basheeraltawil/parallel-manipulator-imu-control/docs/Presentation1.pptx

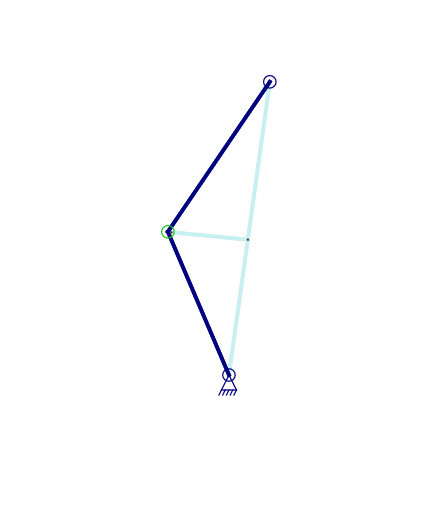
[picture p14: figure]

L2i

a

h

α

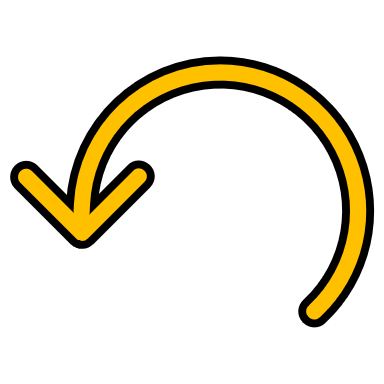
[picture p15: figure]
Line arrow Rotate left

L1i

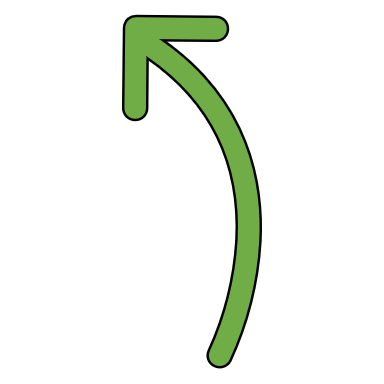
[picture p16: figure]
Line arrow Counter clockwise curve

a

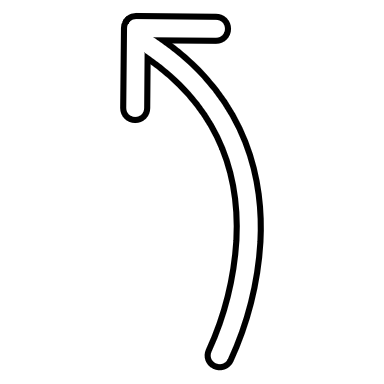
[picture p17: figure]
Line arrow Counter clockwise curve

θ

(β)

X

## Slide 2

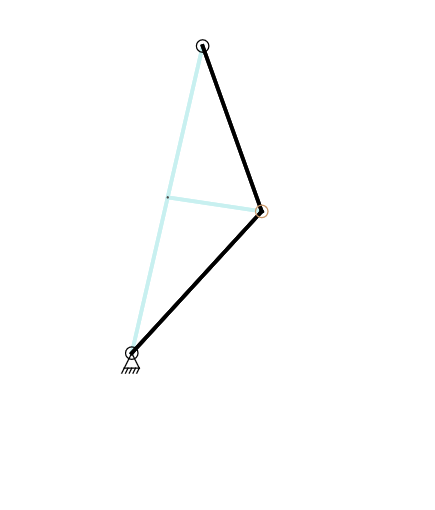
[picture p18: figure]

a

L2i

h

a

α

L1i

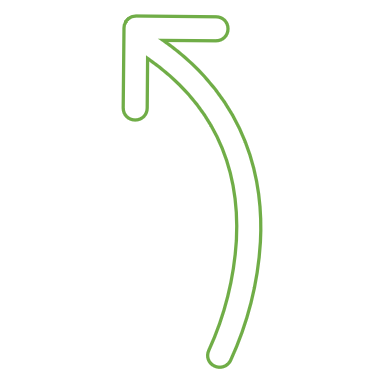
[picture p19: figure]
Line arrow Counter clockwise curve

(β)

θ

X
