basheeraltawil/parallel-manipulator-imu-control/docs/RO1.pptx

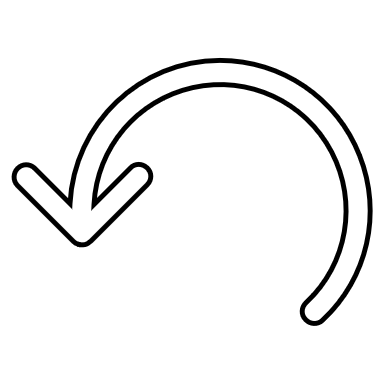
[picture p20: figure]
Line arrow Rotate left

θ 3

x_2

L13

y_0

L23

(P_(x3) ,P_(y3) )

Platform

(P_x ,P_y )

(P_(x2) ,P_(y2) )

L21

(P_(x1) ,P_(y1) )

L22

L11

Line arrow Counter clockwise curve

L12

θ 1

x_0

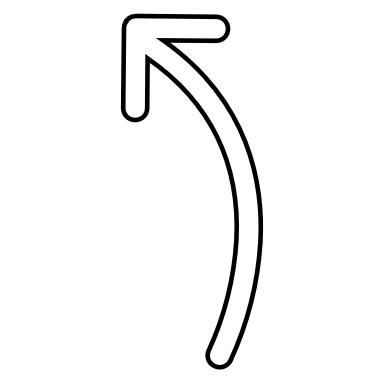
[picture p21: figure]
Line arrow Counter clockwise curve

θ 2

x_1

Page 1

## Slide 2
