basheeraltawil/parallel-manipulator-imu-control/docs/media/learning/fig09_dynamics.png

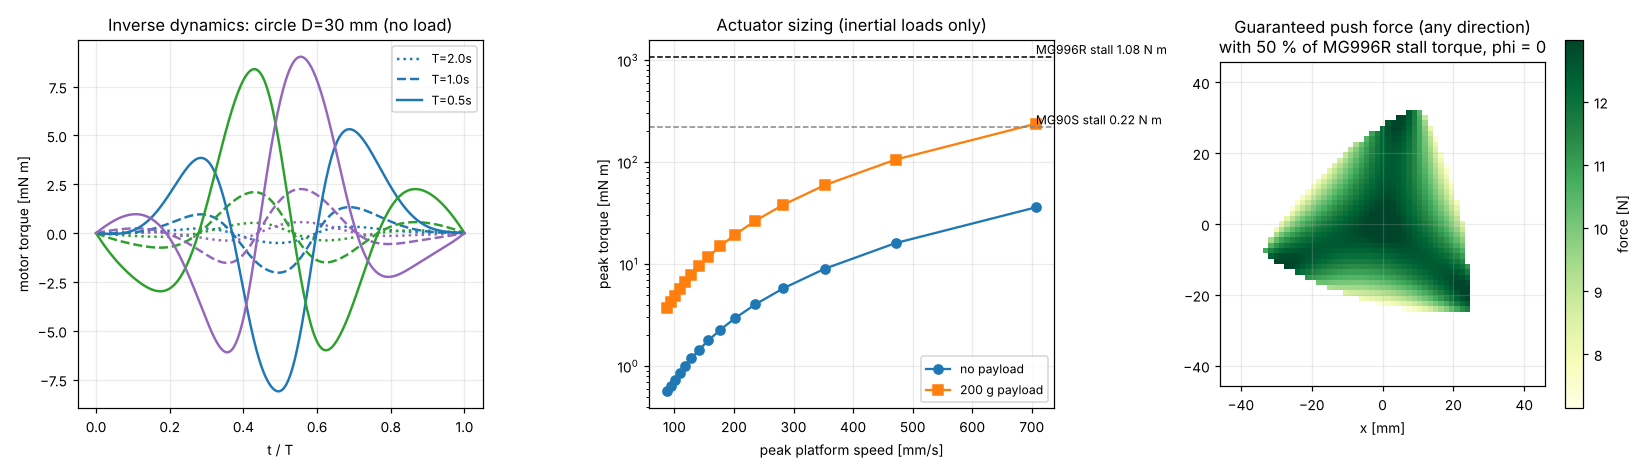
docs/media/learning/fig09_dynamics.png
