basheeraltawil/parallel-manipulator-imu-control/docs/media/learning/robot_render_top.png

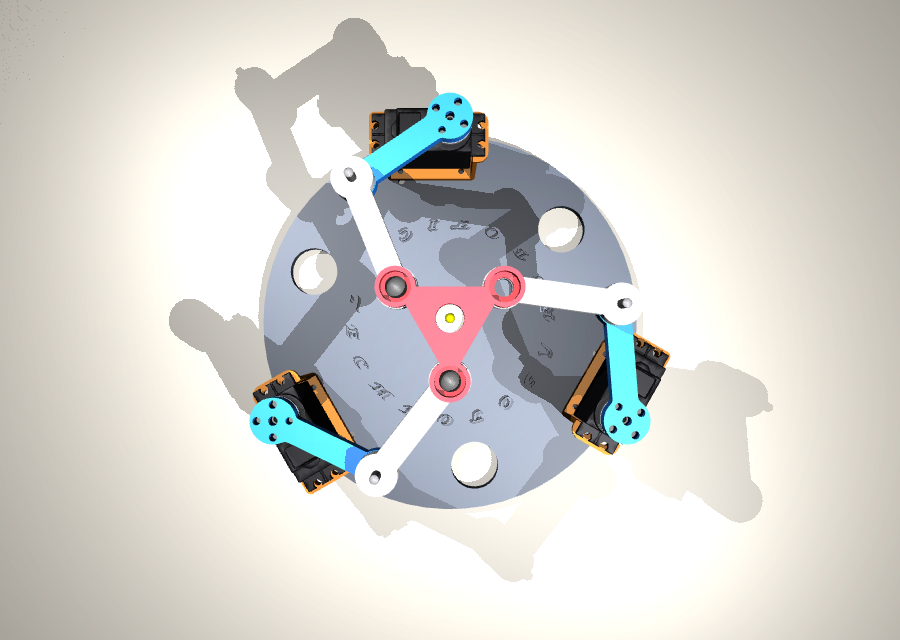
docs/media/learning/robot_render_top.png
