basheeraltawil/parallel-manipulator-imu-control/docs/media/overview.gif

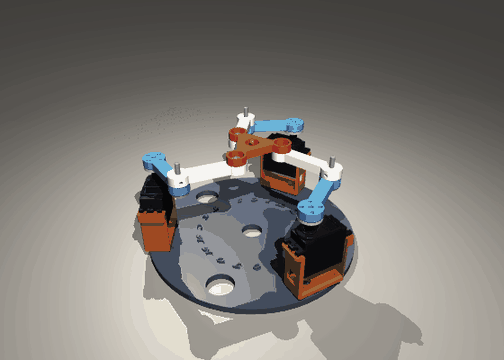
docs/media/overview.gif
