basheeraltawil/parallel-manipulator-imu-control/docs/media/scenarios/s1_imu_teleoperation.gif

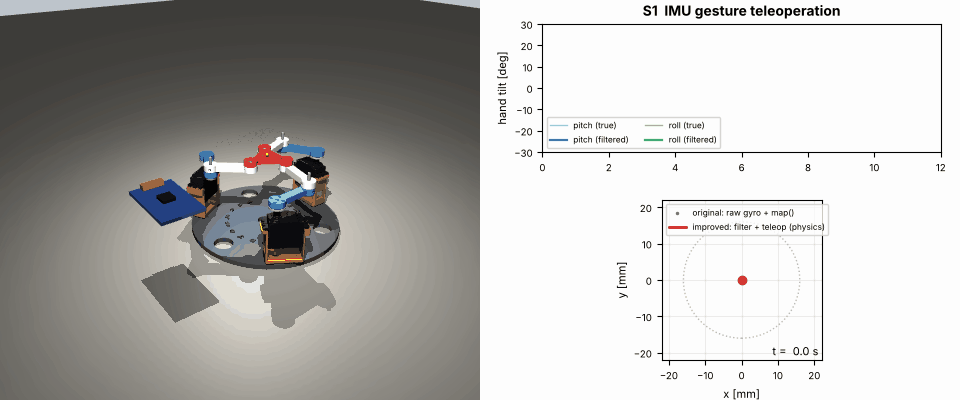
docs/media/scenarios/s1_imu_teleoperation.gif
