basheeraltawil/parallel-manipulator-imu-control/docs/media/scenarios/s2_precision_pick_place.gif

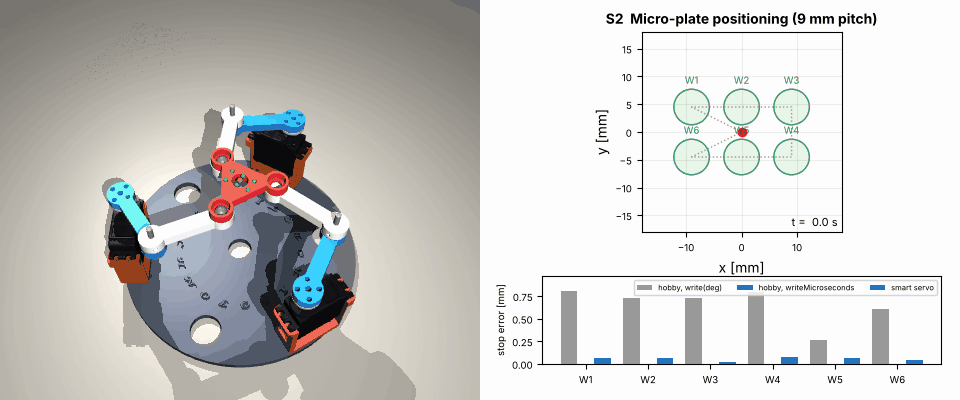
docs/media/scenarios/s2_precision_pick_place.gif
