basheeraltawil/parallel-manipulator-imu-control/hardware/vendor_models/mg90s/1.JPG

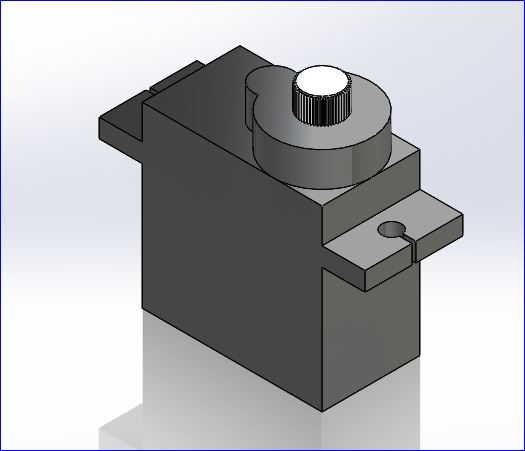
hardware/vendor_models/mg90s/1.JPG
