basheeraltawil/parallel-manipulator-imu-control/servomotor-mg996r-1.snapshot.1/fn.JPG

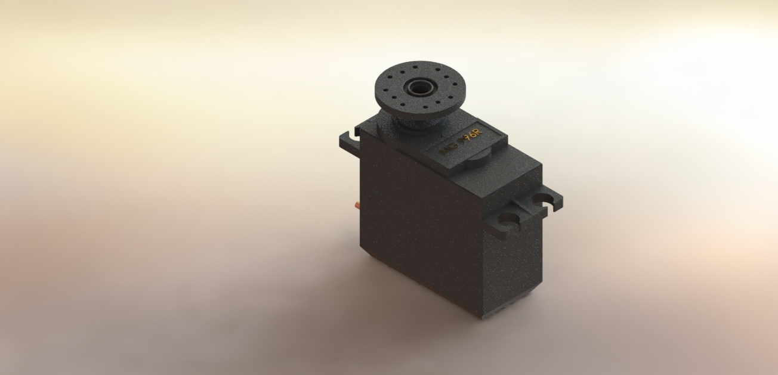
servomotor-mg996r-1.snapshot.1/fn.JPG
