basheeraltawil/parallel-manipulator-imu-control/servomotor-mg996r-1.snapshot.1/Ensamble_servo_MG996R.SLDASM

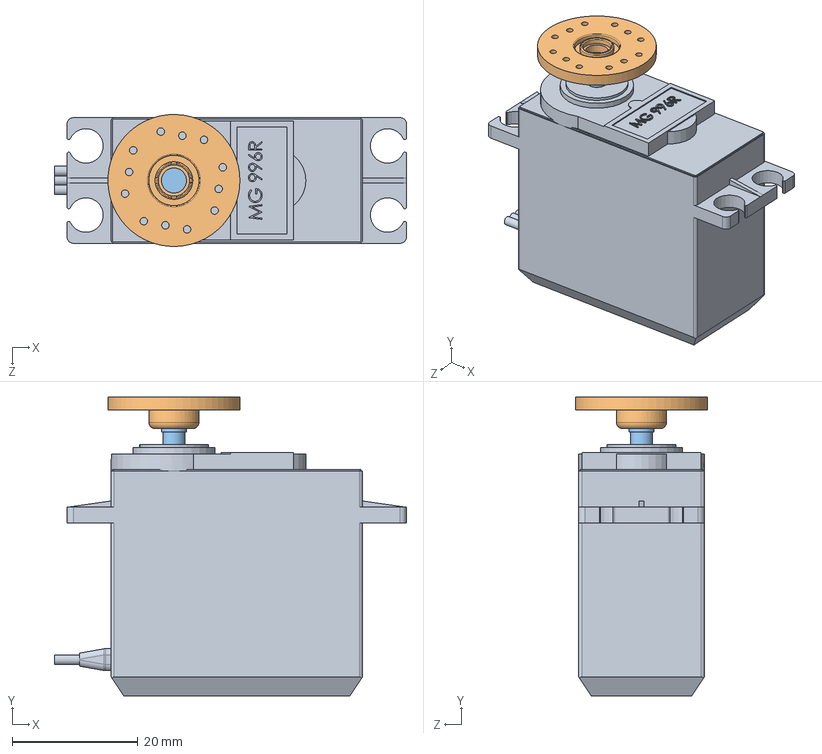
[picture p30: CAD file, 2026-10-26]
servomotor-mg996r-1.snapshot.1/Ensamble_servo_MG996R.SLDASM
56.0 x 47.5 x 21.0 mm
Servomg996r
disco_1
Engrane_cabezal_servo
