basheeraltawil/parallel-manipulator-imu-control/hardware/cad/solidworks/Assem1.SLDASM

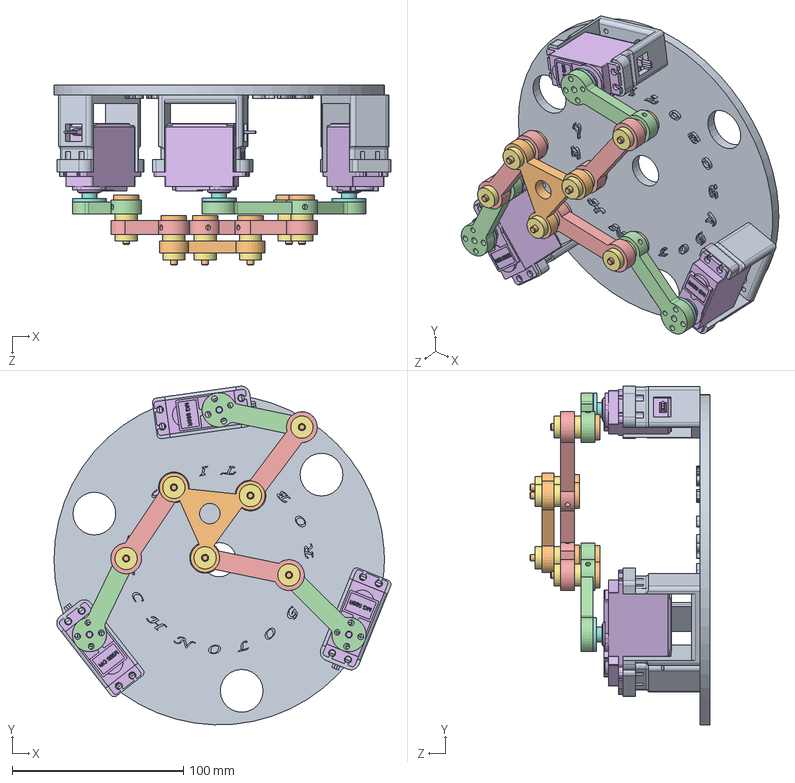
[picture p31: CAD file, 2026-10-30]
hardware/cad/solidworks/Assem1.SLDASM
196.9 x 197.8 x 105.3 mm
base
end_effector
bearing x 6
connecting_bar x 3
middle_bar x 3
servo body x 3
CIRCLE_SUP x 12
servo dise v1 x 3
base22 x 3
b_connection x 6
