basheeraltawil/parallel-manipulator-imu-control/cad/Servo Bracket - universal v10_1.sldasm

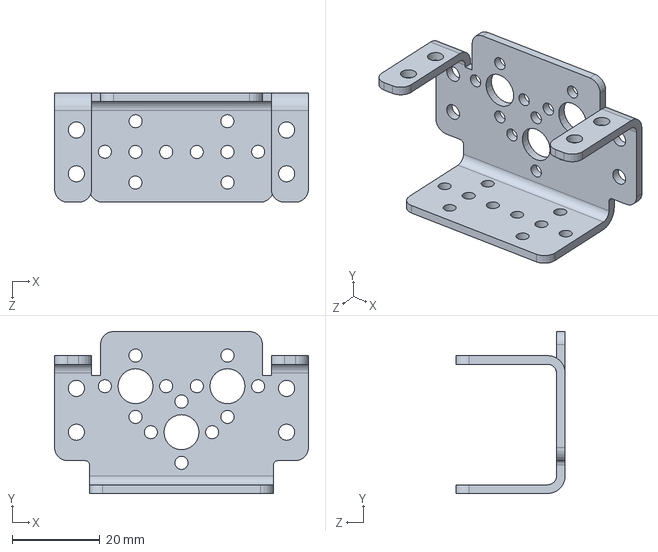
[picture p32: CAD file, 2026-10-26]
cad/Servo Bracket - universal v10_1.sldasm
58.0 x 37.0 x 25.0 mm
