basheeraltawil/parallel-manipulator-imu-control/cad/servo with bracket v9.SLDASM

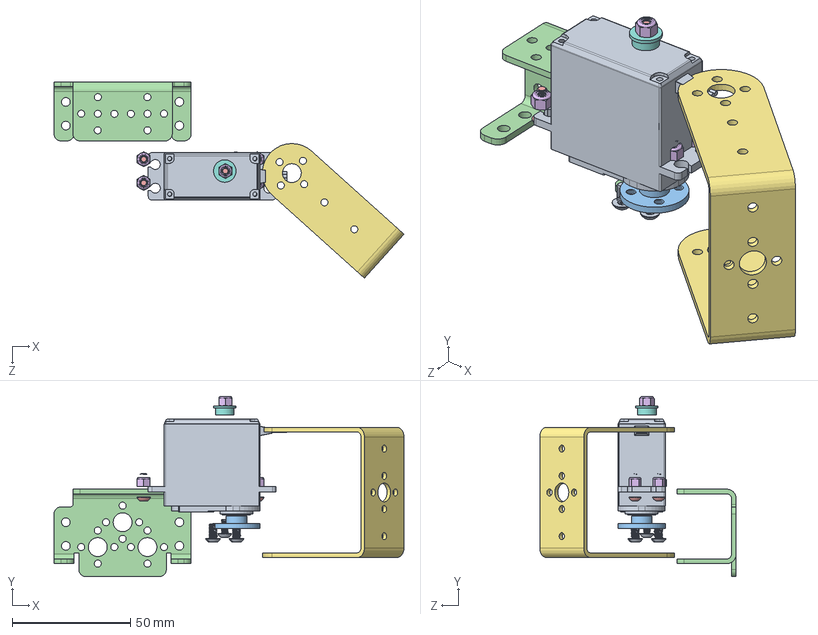
[picture p33: CAD file, 2026-10-26]
cad/servo with bracket v9.SLDASM
147.9 x 76.2 x 83.0 mm
servo body
TowerPro-MG995_pulley v1
servo dise v1
Servo Bracket - universal
M3x10 x 5
M3 safe nut x 5
Servo Bracket - long U
brass brushing
M3x6 x 5
