basheeraltawil/parallel-manipulator-imu-control/cad/SERVO_H.SLDPRT

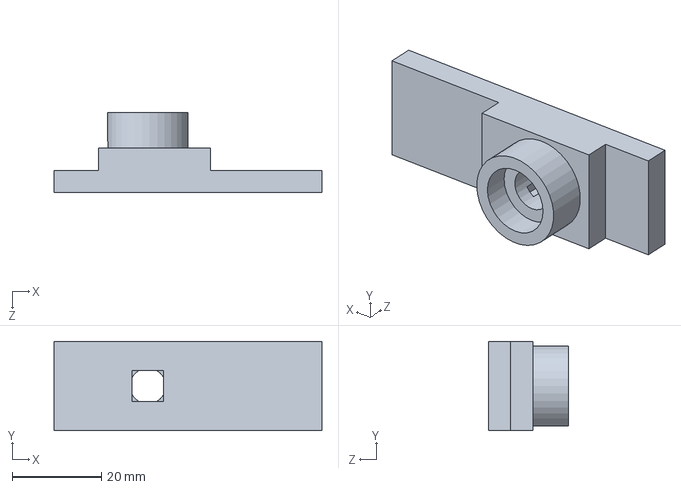
[picture p34: CAD file, 2026-10-26]
cad/SERVO_H.SLDPRT
60.0 x 20.0 x 18.0 mm
