basheeraltawil/parallel-manipulator-imu-control/hardware/cad/solidworks/middle_bar.SLDPRT

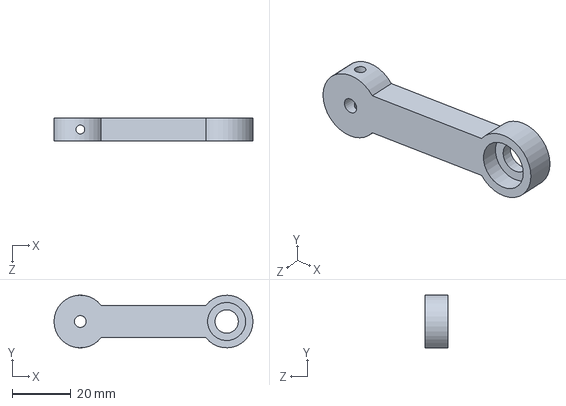
[picture p35: CAD file, 2026-10-30]
hardware/cad/solidworks/middle_bar.SLDPRT
68.0 x 18.0 x 8.00 mm
