basheeraltawil/parallel-manipulator-imu-control/hardware/stl/servo_con2_Component1 v2.stl

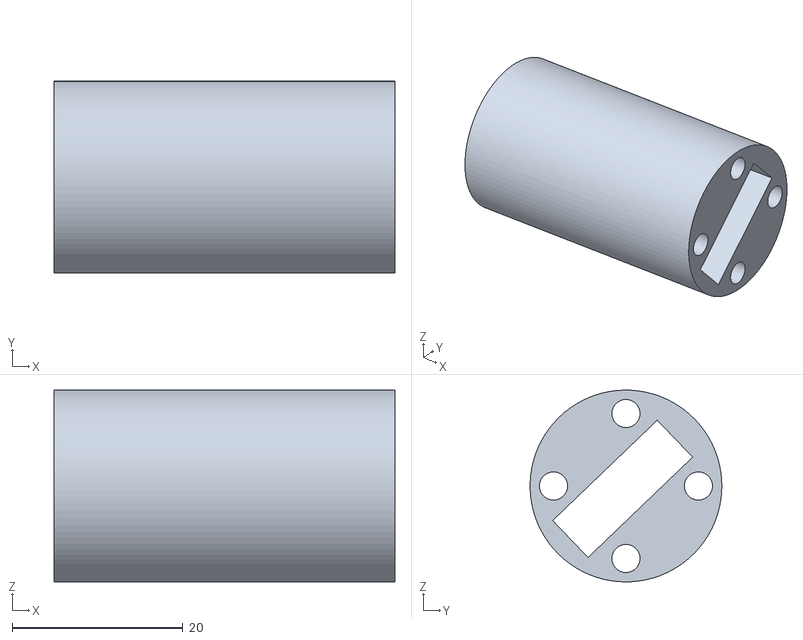
[picture p36: CAD file, 2026-10-30]
hardware/stl/servo_con2_Component1 v2.stl
40.0 x 22.5 x 22.5
