basheeraltawil/parallel-manipulator-imu-control/hardware/vendor_models/mg90s/MG90S.IGS

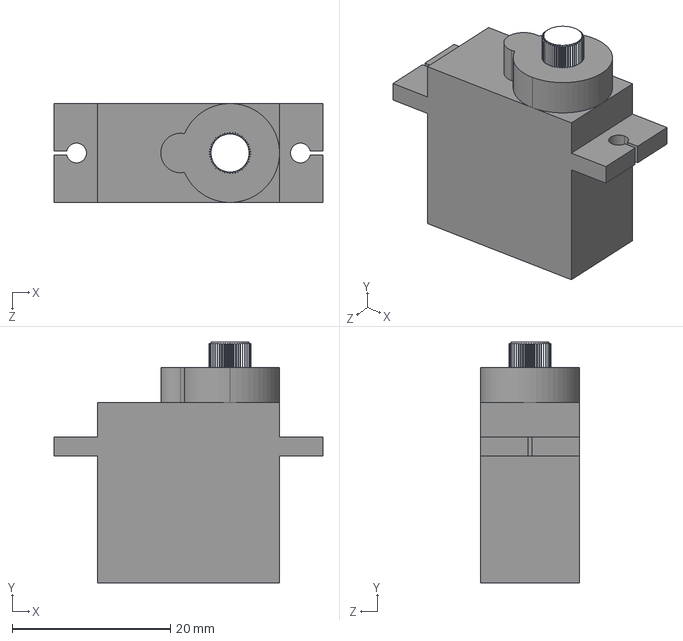
[picture p37: CAD file, 2026-10-30]
hardware/vendor_models/mg90s/MG90S.IGS
34.0 x 30.4 x 12.5 mm
