basheeraltawil/parallel-manipulator-imu-control/hardware/vendor_models/mg995_with_bracket/Servo Bracket - long U v3.step

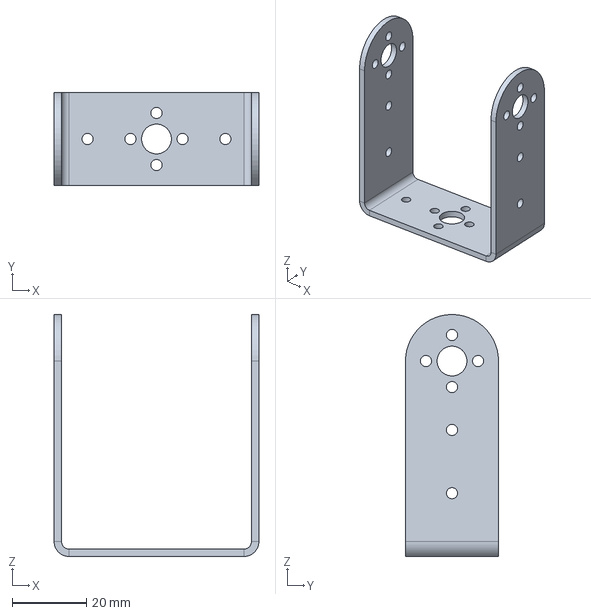
[picture p38: CAD file, 2026-10-30]
hardware/vendor_models/mg995_with_bracket/Servo Bracket - long U v3.step
55.0 x 25.0 x 65.0 mm
