basheeraltawil/parallel-manipulator-imu-control/hardware/vendor_models/mg996r/Servo MG996R.SLDPRT

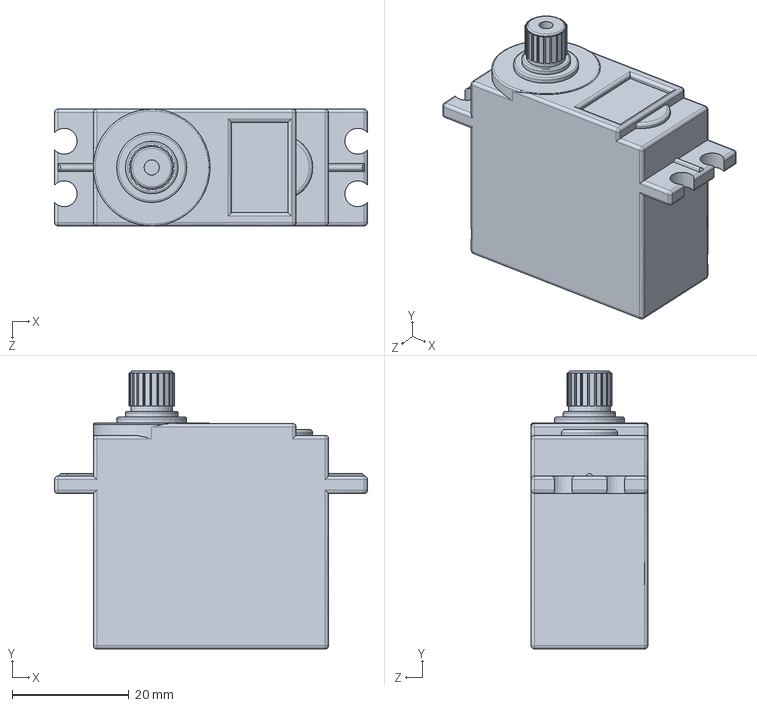
[picture p39: CAD file, 2026-10-30]
hardware/vendor_models/mg996r/Servo MG996R.SLDPRT
53.6 x 47.6 x 20.0 mm
