basheeraltawil/parallel-manipulator-imu-control/mg90s-servomotor-1.snapshot.2/MG90S.SLDPRT

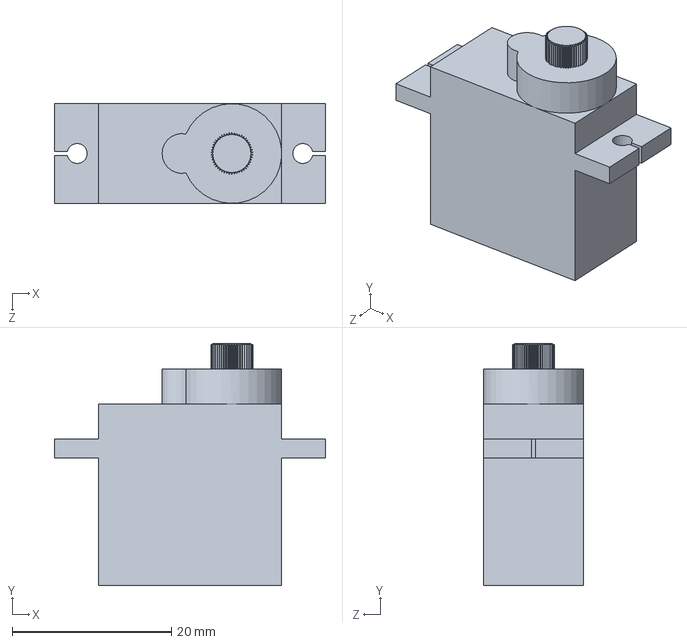
[picture p40: CAD file, 2026-10-26]
mg90s-servomotor-1.snapshot.2/MG90S.SLDPRT
34.0 x 30.4 x 12.5 mm
