basheeraltawil/parallel-manipulator-imu-control/mg995-with-mount-1.snapshot.10/MG996 v1 v12.step

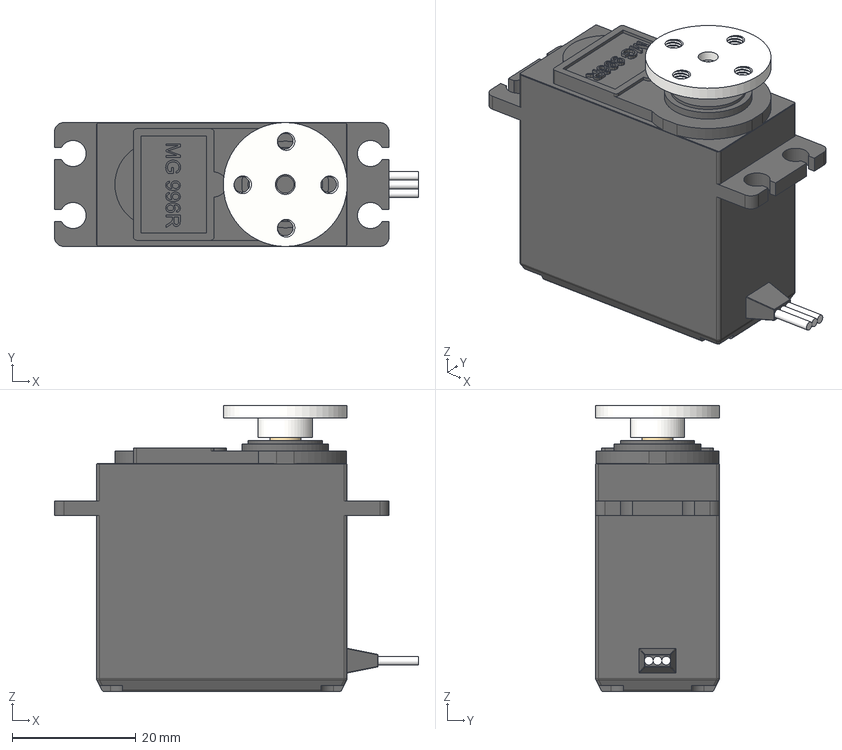
[picture p41: CAD file, 2026-10-26]
mg995-with-mount-1.snapshot.10/MG996 v1 v12.step
58.8 x 20.0 x 46.2 mm
servo body
TowerPro-MG995_pulley v1
servo dise v1
