basheeraltawil/parallel-manipulator-imu-control/ros2_ws/src/pm3rrr_description/meshes/collision/joint_pin.stl

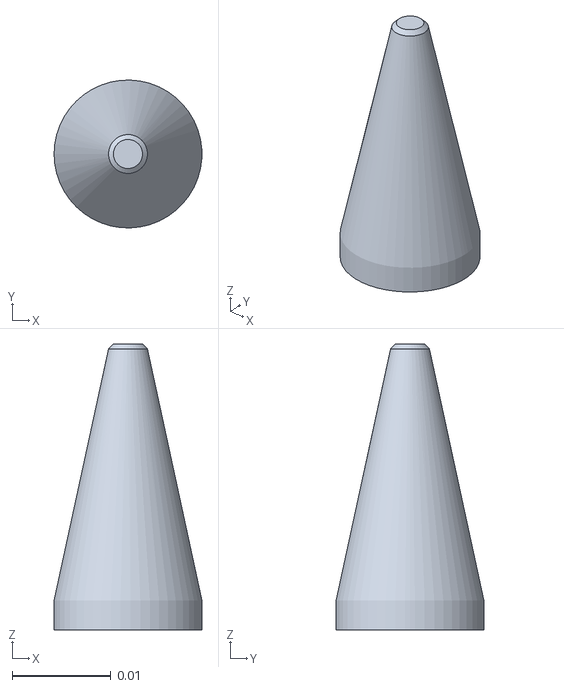
[picture p42: CAD file, 2026-10-30]
ros2_ws/src/pm3rrr_description/meshes/collision/joint_pin.stl
0.015 x 0.015 x 0.029
