basheeraltawil/parallel-manipulator-imu-control/ros2_ws/src/pm3rrr_description/meshes/visual/distal_link.stl

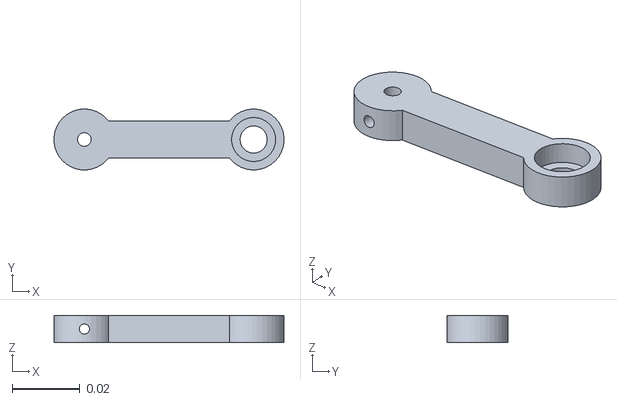
[picture p43: CAD file, 2026-10-30]
ros2_ws/src/pm3rrr_description/meshes/visual/distal_link.stl
0.0679 x 0.018 x 0.008
