basheeraltawil/parallel-manipulator-imu-control/stl_files/base1.STL

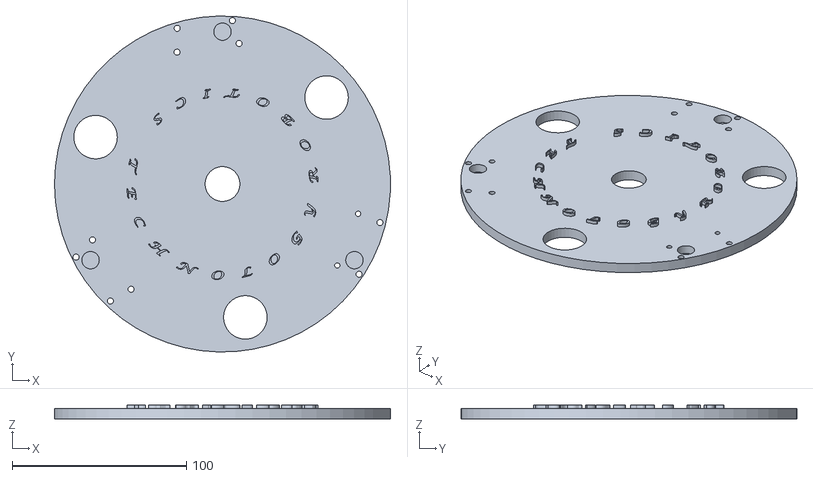
[picture p44: CAD file, 2026-10-26]
stl_files/base1.STL
193.0 x 192.9 x 8.00
