basheeraltawil/parallel-manipulator-imu-control/hardware/cad/solidworks/servo dise v1.sldprt

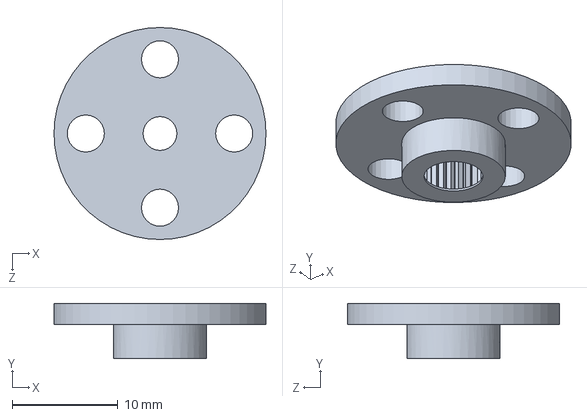
[picture p45: CAD file, 2026-10-30]
hardware/cad/solidworks/servo dise v1.sldprt
20.0 x 5.20 x 20.0 mm
