basheeraltawil/parallel-manipulator-imu-control/mg995-with-mount-1.snapshot.10/servo with bracket v9.step

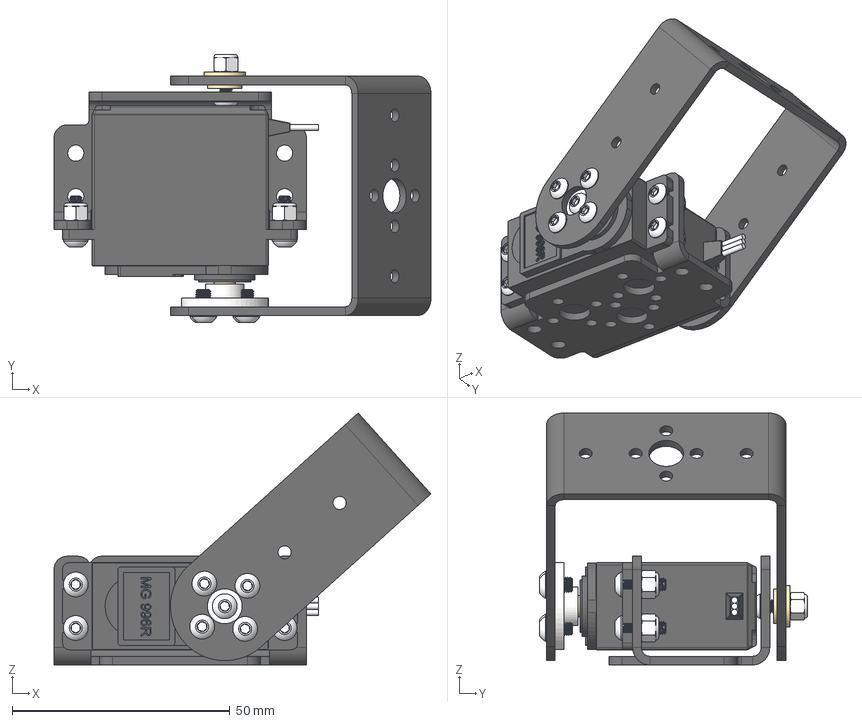
[picture p46: CAD file, 2026-10-26]
mg995-with-mount-1.snapshot.10/servo with bracket v9.step
86.6 x 61.7 x 57.9 mm
servo body
TowerPro-MG995_pulley v1
servo dise v1
Servo Bracket - universal
M3x10 x 5
M3 safe nut x 5
Servo Bracket - long U
brass brushing
M3x6 x 5
