basheeraltawil/parallel-manipulator-imu-control/ros2_ws/src/pm3rrr_description/meshes/collision/proximal_link.stl

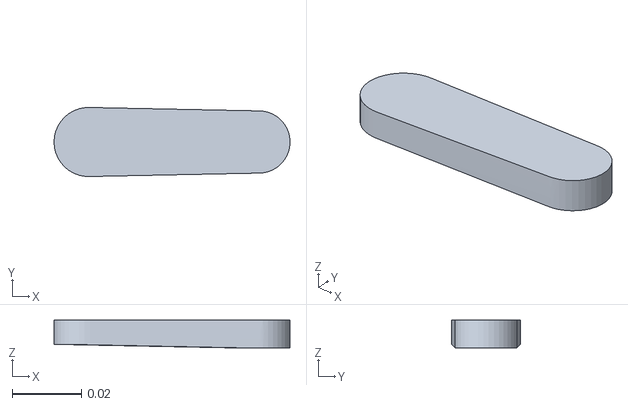
[picture p47: CAD file, 2026-10-30]
ros2_ws/src/pm3rrr_description/meshes/collision/proximal_link.stl
0.0683 x 0.02 x 0.008
