basheeraltawil/parallel-manipulator-imu-control/stl_files/base221.STL

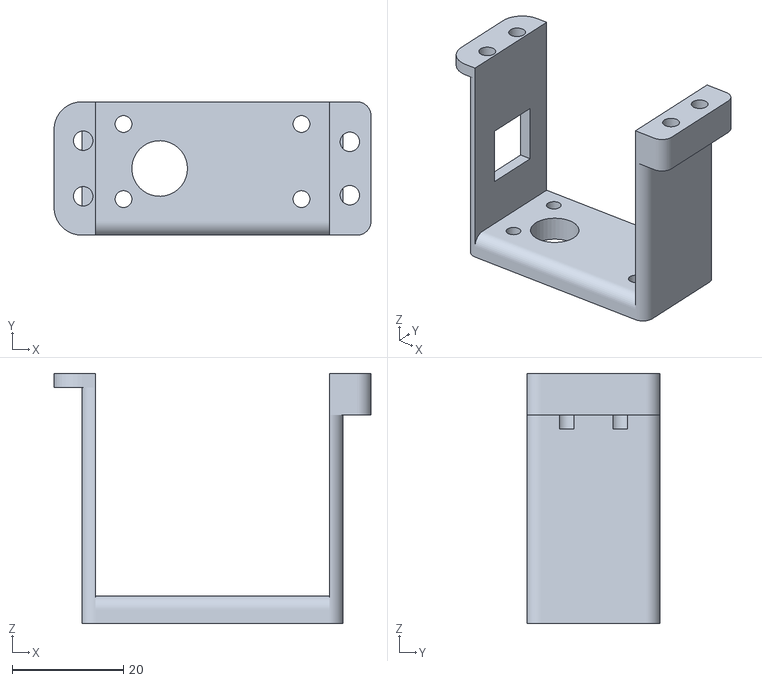
[picture p49: CAD file, 2026-10-26]
stl_files/base221.STL
57.0 x 24.0 x 45.0
