basheeraltawil/parallel-manipulator-imu-control/ros2_ws/src/pm3rrr_description/meshes/visual/servo_cradle.stl

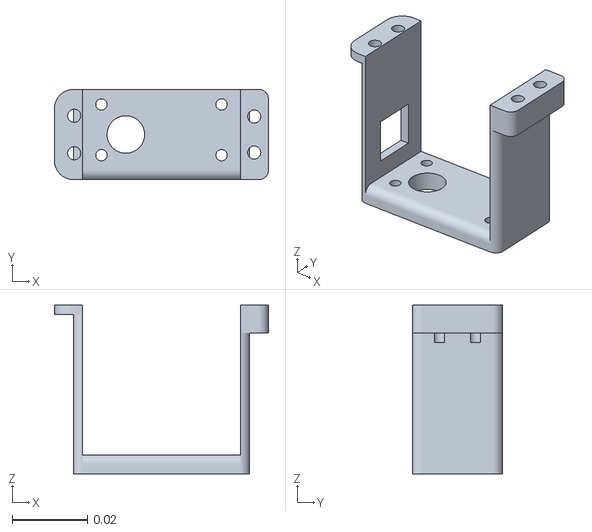
[picture p51: CAD file, 2026-10-30]
ros2_ws/src/pm3rrr_description/meshes/visual/servo_cradle.stl
0.057 x 0.024 x 0.045
