basheeraltawil/parallel-manipulator-imu-control/stl_files/b_connection2.STL

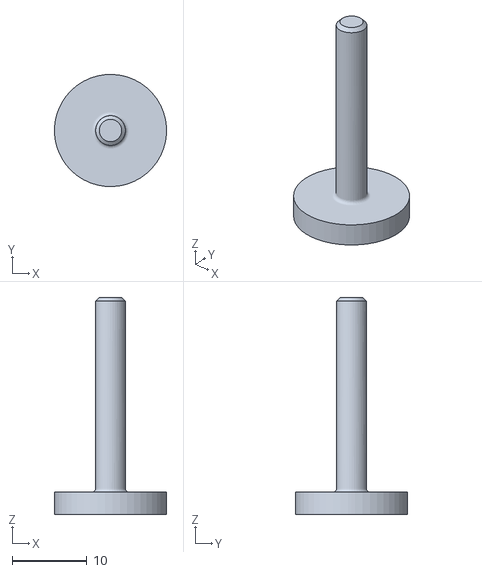
[picture p52: CAD file, 2026-10-26]
stl_files/b_connection2.STL
15.0 x 15.0 x 29.0
