basheeraltawil/parallel-manipulator-imu-control/cad/base22.SLDPRT

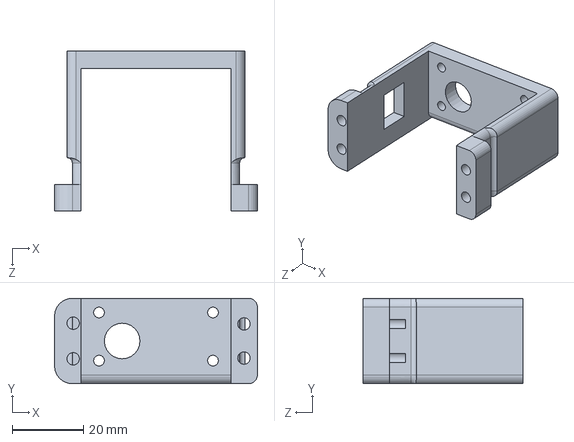
[picture p53: CAD file, 2026-10-26]
cad/base22.SLDPRT
57.0 x 24.0 x 45.0 mm
