basheeraltawil/parallel-manipulator-imu-control/ros2_ws/src/pm3rrr_description/meshes/collision/base_plate.stl

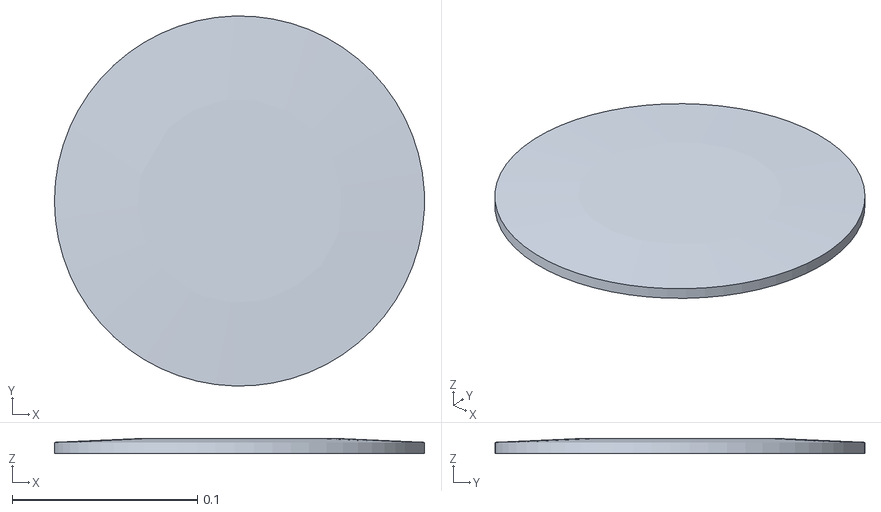
[picture p54: CAD file, 2026-10-30]
ros2_ws/src/pm3rrr_description/meshes/collision/base_plate.stl
0.2 x 0.2 x 0.008
