basheeraltawil/parallel-manipulator-imu-control/stl_files/n2_base v8.stl

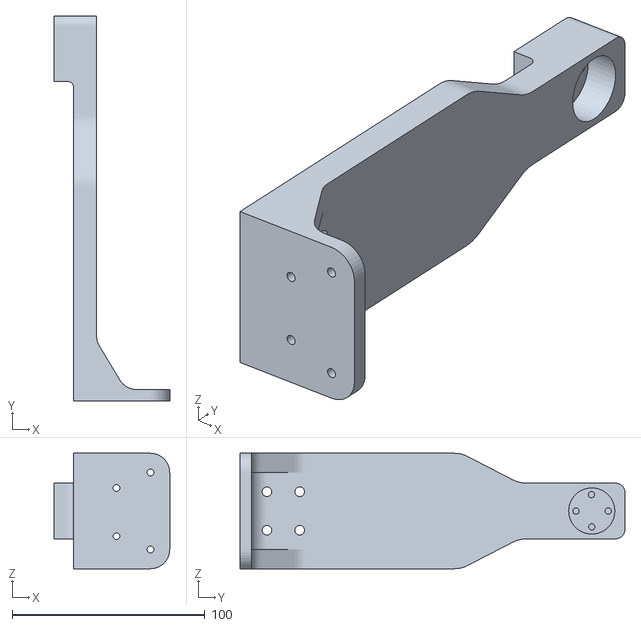
[picture p55: CAD file, 2026-10-26]
stl_files/n2_base v8.stl
60.0 x 200.0 x 60.0
