basheeraltawil/parallel-manipulator-imu-control/ros2_ws/src/pm3rrr_description/meshes/collision/platform.stl

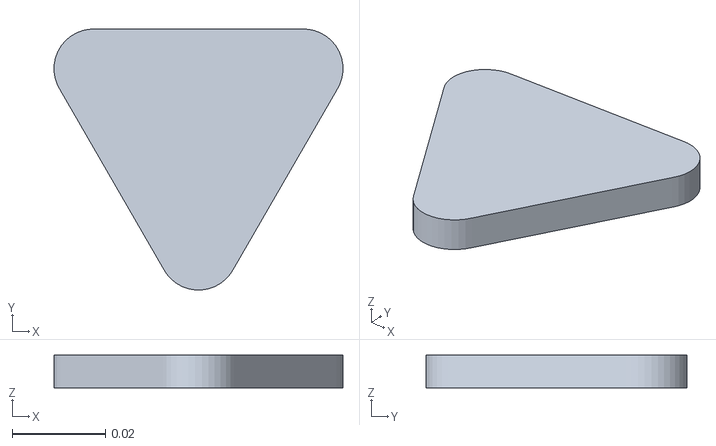
[picture p56: CAD file, 2026-10-30]
ros2_ws/src/pm3rrr_description/meshes/collision/platform.stl
0.062 x 0.0559 x 0.007
