basheeraltawil/parallel-manipulator-imu-control/stl_files/CIRCLE1_SUP.STL

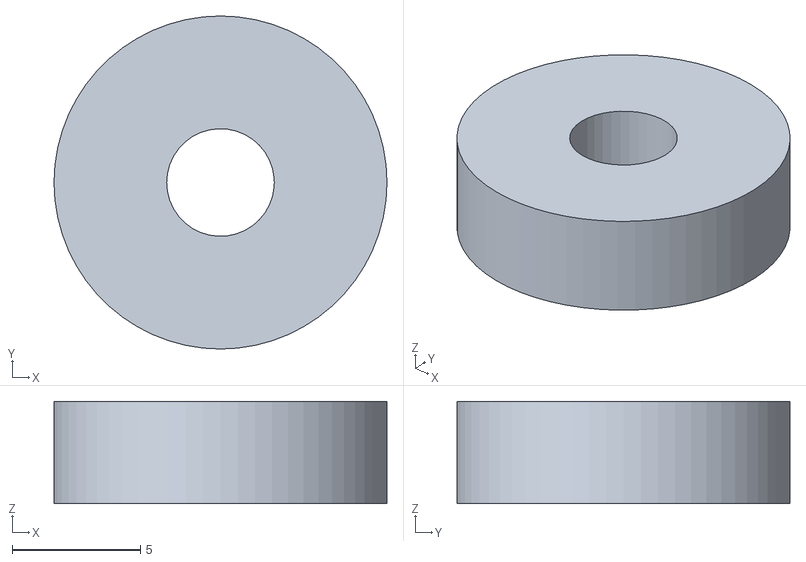
[picture p57: CAD file, 2026-10-26]
stl_files/CIRCLE1_SUP.STL
13.0 x 13.0 x 4.00
