basheeraltawil/parallel-manipulator-imu-control/cad/end_effector.SLDPRT

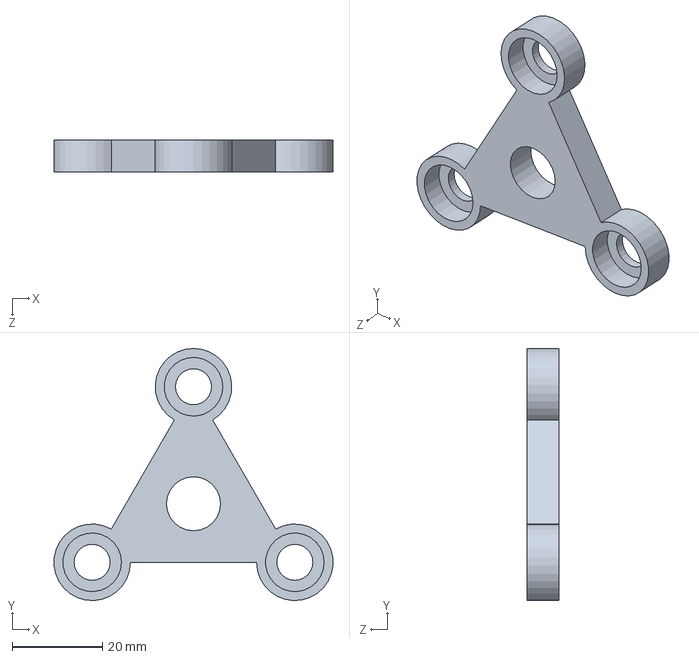
[picture p58: CAD file, 2026-10-26]
cad/end_effector.SLDPRT
61.9 x 56.0 x 7.00 mm
