basheeraltawil/parallel-manipulator-imu-control/cad/connecting_bar.SLDPRT

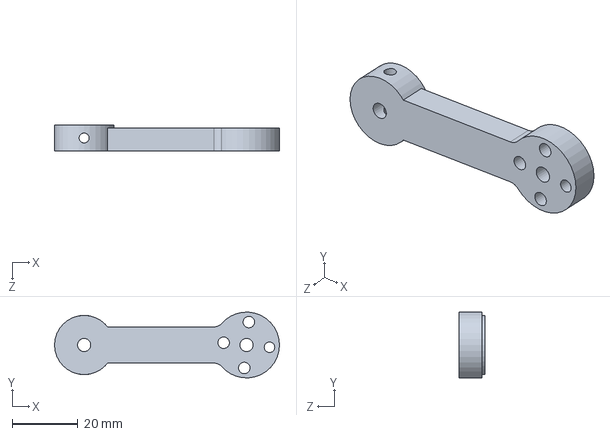
[picture p59: CAD file, 2026-10-26]
cad/connecting_bar.SLDPRT
68.4 x 19.9 x 8.00 mm
