basheeraltawil/parallel-manipulator-imu-control/cad/SERVO_TOLLER.SLDPRT

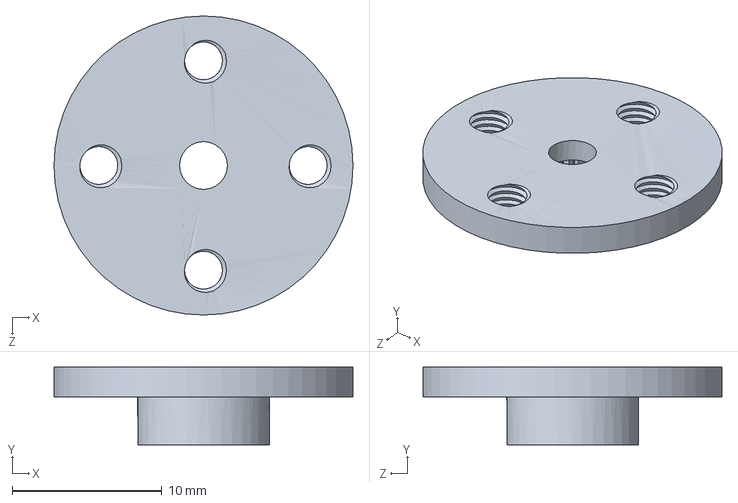
[picture p60: CAD file, 2026-10-26]
cad/SERVO_TOLLER.SLDPRT
20.0 x 5.20 x 20.0 mm
