basheeraltawil/parallel-manipulator-imu-control/cad/support.SLDPRT

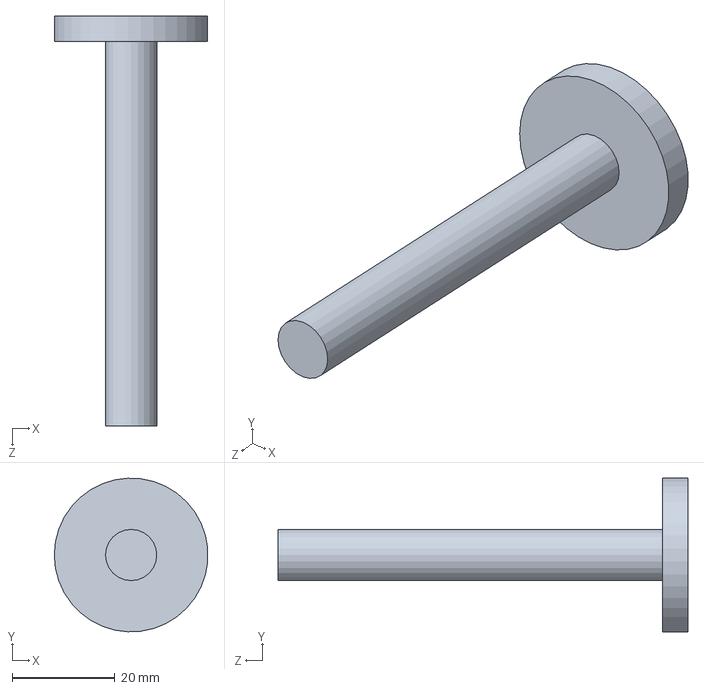
[picture p61: CAD file, 2026-10-26]
cad/support.SLDPRT
29.9 x 30.0 x 80.0 mm
