basheeraltawil/parallel-manipulator-imu-control/(list of files, cad)

Other CAD files:
cad/Servo Bracket - long U v3_1.sldasm
hardware/cad/solidworks/MG996 v1 v12_1.sldasm
cad/brass brushing v1.sldasm
cad/Servo MG996R.SLDPRT
hardware/cad/solidworks/Servo Bracket - universal.sldprt
stl_files/servo dise v1.STL
cad/brass brushing.sldprt
stl_files/base222.STL
cad/footprints.SLDPRT
cad/CIRCLE_SUP.SLDPRT
cad/MG90S.SLDPRT
cad/M3x10.sldprt
cad/screws and nuts.sldasm
hardware/stl/middle_bar.STL
hardware/vendor_models/mg90s/MG90S.x_t
mg90s-servomotor-1.snapshot.2/MG90S.OBJ
stl_files/CIRCLE_SUP.STL
stl_files/connecting_bar.STL
