basheeraltawil/parallel-manipulator-imu-control/(commit log)

2026-10-26 Initial commit: parallel manipulator with IMU control
2026-10-30 Restructure into a complete ROS 2 Humble robotics project and course
    - pm3rrr_core: tested ROS-free library (IK/FK, Jacobians, singularities,
    workspace, virtual-work dynamics, trajectories, IMU fusion, planning guard)
    - CAD -> URDF pipeline (tools/cad_to_urdf): measured pivots, link-frame
    meshes, collision hulls, inertia, loop-aware SRDF, validation
    - ROS 2 packages: description (xacro, zero=home, loop closures),
    control (controller + singularity guard, scenarios, IMU teleop, FK monitor,
    serial bridge), gazebo (ros2_control effort JTC), bringup launch files
    - MuJoCo physics of the same URDF with five industrial scenarios, GIFs, MP4s
    - New Arduino firmware with host unit tests; bring-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
